computourist/RFM69-MQTT-client/DHT end node/DHT-node.png

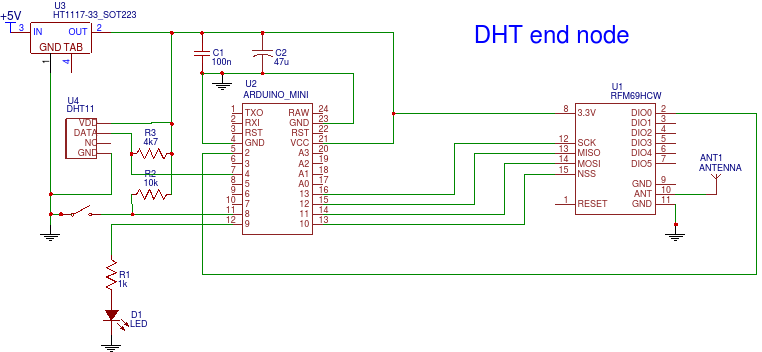
DHT end node/DHT-node.png
