computourist/RFM69-MQTT-client/DIG end node/DIG-node.png

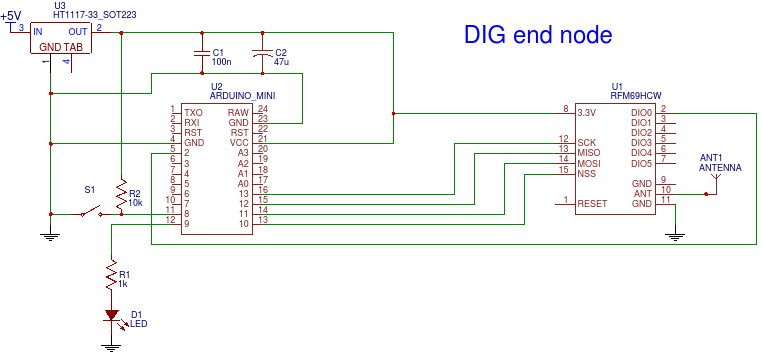
DIG end node/DIG-node.png
