computourist/RFM69-MQTT-client/DIG end node/DIG_node_relay.PNG

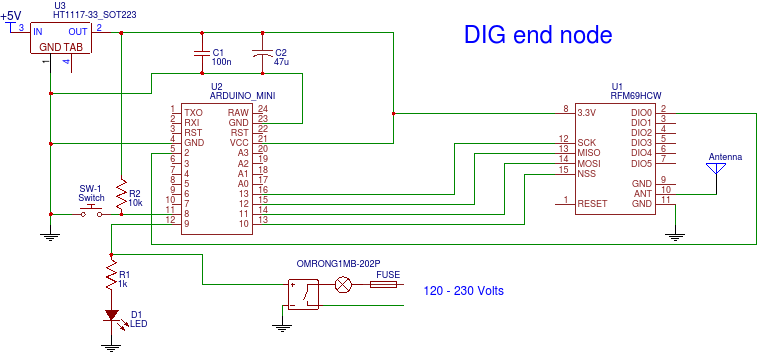
DIG end node/DIG_node_relay.PNG
