computourist/RFM69-MQTT-client/Gateway_2.5/MQTT-GTW.png

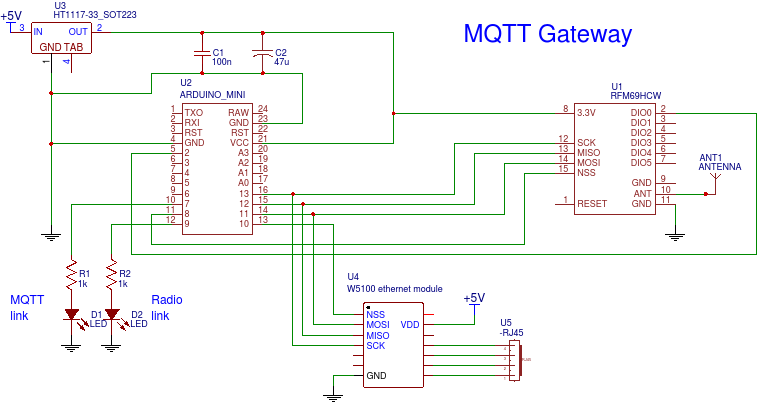
Gateway_2.5/MQTT-GTW.png
