computourist/RFM69-MQTT-client/(threads)

Thread 1 (2015-01-28):

Gateway stops functioning after a couple of polls/writes

cub69, 2015-01-28:
Hi, nice solution.  I've built both the gateway and the node.  The hardware I'm using is slightly different, I'm using arduino Mega 2560's, a different ethernet device - but the library (UIPethernet) is appartently 100% compatible with ethernet.h.
The gateway comes up and on my mosquito side I see it begin to send PINGREQ and getting PINGRESP.
I bring up the node and it sends a dev99 and then the temp/humidity.  I will see this publish if the gateway has not already gotten lost.  After a few minutes the gateway just stops - no more ping requests, and no more forwarding of data.  If I do a soft reset it comes back to life until it stops again.  Any suggestions on how to figure this out?  It most often stops after receiving sensor data, but has occasionally stopped without receiving it as well.

Thx

computourist, 2015-01-28:
Hi Cub69,

This is probably a hardware problem. I myself never encountered such problems; my gateway/node hase been running weeks at a time without problems.
Others have had such ussues, and found solutions. Maybe the discussions on http://homeautomation.proboards.com/ are of use to you...
- Computourist

cub69, 2015-01-28:
thanks found the forum - looking at solutions.

Closed 2015-01-28.

Thread 2 (2015-02-21):

using serial instead of Ethernet

einsiedlerkrebs, 2015-02-21:
Hello Computourist,

i am happy to find your code, since i was looking for an MQTT(-SN) implementation for arduinos and RFM69. I was wondering how it would be possible, to run the gateway without an Ethernet shield, but an UART-serial instead? The scenario would be, that the GW-Arduino is connected to a third device (i.e. openWRT-machine with broker) using the serial to communicate with the broker.
An advatage is that you could use  a arduino pro mini with 3.3V directly with the radio modules an lower the hardware costs.

Thank you for the code (!) and for your help.

computourist, 2015-02-21:
Hello Einsiedlerkrebs,

I chose for this setup for the following reasons:
- MQTT is designed to run on top of TCP/IP ; running it over a serial line means a proprietary solution and needs extra code on the receiving end (Mosquitto).
- The gateway is an important part of the installation. I do not like the idea of building a bottleneck (limited serial transfer speed) in such a central part.
- The physical location of the gateway is determined by coverage of the radio network. Your radio gateway will probably not sit right next to your Mosquitto broker, as would be needed for a serial connection. Ethernet gives you the freedom of physically moving the gateway around.
- The extra cost is just one ethernet module. You only need a single gateway per installation, so this would not seem a great problem.

I know that development is going on to implement a gateway together with a broker on Raspberry Pi. Have a look to the following forum for some inspiration:

http://homeautomation.proboards.com/

Regards,
- Computourist

einsiedlerkrebs, 2015-02-23:
hi,

i do not mean, to make RFM69-MQTT-client depending on such a setting, but still it would be usefull. In my case i would like to use it in such a way, since

* i have 3.3v Arduinos (Ethernet shield will not work)
* i could port the serial to udp via socat.

is it not possible, to use such a setting via an ifdef option? I am just asking cause i dont know, ho to change the Ethernet based commands to serial based ones.

Regards

einsiedlerkrebs

computourist, 2015-02-23:
Hi,
- you can use the ethershield with a 3.3 Volt Arduino.
- you cannot change the Ethernet based commands to serial ones. MQTT is based on TCP/IP and you cannot send it over serial. You could build a workaround, but on de broker-machine you would need code to convert the serial back to MQTT. Socat is character based and will not work straight away.

Rgds,
Computourist

Closed 2015-03-03.

Thread 5 (2015-04-29):

version 2.2 Gateway -- Freezing

davidhrbaty, 2015-04-29:
Hello computourist,
I'm trying your code of Gateway, but I have big strange with freezing after several minutes. When I turned off debug, it was better to take uptime several minutes. Can you advise me, where can be a  problem? I downloaded the newest version RFM libraries, but problem still persist.

Thank you

computourist, 2015-05-12:
Hi David,

Sorry for the delay in replying; I have been abroad for some time.

It is hard for me to debug your gateway. You would have to indicate exactly
how you put together the hardware and how you implemented your MQTT broker.
Is your gateway faulty or are the end nodes failing ? Is the link with the
broker down or not ?

My experience is these problems in most cases are power supply related.
Make sure your power supply delivers enough current and yout 3.3 Volts
supply for the RFM module can deliver the current needed in high-power
mode. Decoupling of the power supply is needed.

Good luck !

Computourist

2015-04-29 23:33 GMT+02:00 David Hrbaty <notifications@github.com>:

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

davidhrbaty, 2015-05-12:
Hi computourist,

Thank you for your response. I know, that it is hard to debug my gateway. So I include my schematic, because I have used arduino with 5V, so I must use 74HC4050 between arduino board and rfm69hw board. There is schematic:

https://lh4.googleusercontent.com/-vKxMicnYmfQ/VVJO1UJzJ6I/AAAAAAAAEOE/YZsUyeWj1cg/w958-h552-no/rfm69_schematic.png

After main change in your code, especially with mqttclient loop:
```
long watchdogInterval = 2000;

if (millis() > watchdog) {
    watchdog += watchdogInterval;
    if (!mqttClient.connected() && !connect_mqtt()) {
      return;
    }
    noInterrupts();
    mqttClient.loop();
    interrupts();
}
}	// end loop

boolean connect_mqtt() {
   mqttCon = 0;
   digitalWrite(MQCON, LOW);
  if (mqttClient.connect(clientName)) {
      mqttCon = 1;				// Yes, we have a link so,
      digitalWrite(MQCON, mqttCon);	// turn on MQTT link indicator and
      mqttClient.subscribe(subTopic);	// re-subscribe to mqtt topic
    return true;
  }
  return false;
}
```
I got uptime for several days. After four days of operation I got freeze of gateway. My wireless nodes are up, but have no connection. After restart gateway, wireless nodes have connection again.

When gateway is in freeze mode, it does not respond to any mqtt message.
MQTT broker (mymousquito) is on the same subnet that wireless gateway.

Thank you for your time.

computourist, 2015-05-13:
Hello David,

have you changed the interrupt handling in file W5100.h before compiling, as indicated in the header of the sketch ?

Rgds,

davidhrbaty, 2015-05-13:
Hi computourist,

Do you mean changes in w5100.h ? Especially this section:
```
#else
inline static void initSS() { DDRB |= _BV(2); };
inline static void setSS() { cli(); PORTB &= ~_BV(2); };
inline static void resetSS() { PORTB |= _BV(2); sei(); };
#endif
```

Because I forgot to change it. I think, that there will be whole problem. I'll try it when I 'll be at home during weekend.

I'll write here the result. Thank you again for your advice.

computourist, 2015-05-13:
Without these changes in W5100.h the RFM69 tries to seize the SPI bus at the same time as ethernet.

Gizzbert, 2015-05-30:
ah, thanks, this helped, I also overlooked it, might be helpful to add the following to the sketch of the gateway:
    //                change %program files\arduino\libraries\Ethernet\src\utility\w5100.h:
    //                #else
    //                inline static void initSS() { DDRB |= _BV(2); };
    //                inline static void setSS() { cli(); PORTB &= ~_BV(2); };
    //                inline static void resetSS() { PORTB |= _BV(2); sei(); };
    //                #endif

thanks, gateway works like a charm now :)

computourist, 2015-05-31:
Good to hear you got it all working now. Have fun !

Closed 2015-05-31.

Thread 6 (2015-05-20):

Unable to use both Ethernet Shield and RFM69 - SPI Slave Problem?

TP1337, 2015-05-20:
Hi, I have a problem regarding the radio and ethernet module.
First of all I tried your setup with a Pro Mini (as in the images) and also with an Uno R3 and level converter so that the RFM69 won't get damaged. Both Arduinos are "compatbile" China versions. I tried two China ethernet shields and I also got the genuine ethernet shield.

Which Arduino IDE are you using? Currently I'm using 1.65 and also tried 1.60. I changed two lines in the w5100.h but it won't work. If I unplug the RFM69 power it instantly connects to the MQTT broker, so it's probably due to the SPI problem.

Please tell me which IDE version you are using and if I should try some different ethernet or SPI files. Thank you very much!

computourist, 2015-05-21:
Hi TP,

I'm using an old version of Arduino IDE (1.05), never bothered to upgrade. But that should not cause any problems.

The SPI conflict only occurs when the RFM module receives a radio packet. The RFM will generate an interrupt request and will access the SPI bus. By disabling responses to the interrupt request whilst the ethernet module is using the SPI bus this problem is solved.

This means the connection to the MQTT broker should be established and remain connected until a conflict occurs. If you have no end node transmitting, no packets are received and the connection with the MQTT-broker should not be affected.

I think you have a different problem.
What is the serial output with/without the RFM connected ? Have you checked your supply voltages with/without the RFM ?

Leaving out the LED's is no problem.

TP1337, 2015-05-21:
Hi computourist,
thank you very much for your quick response! Your comment helps me a lot.

I tried both mb102 as well as usb (and batteries). Maybe it's a good idea to connect it to a better voltage source to be sure it's not a power problem. I will also try IDE 1.05 - all I have to is to set ip, mac etc. and change the two lines in the w5100.h header file, right? Just asking because it doesn't seem to work although I'm trying very hard and I'm experienced with this kind of setups.

If I connect both the rfm69 (not high power version) and ethernet to the pro mini or uno the console only says "failed to connect" once and then kind of freezes. Without the rfm69 it connects immediatedly after one failed connect. I will check everything asap.

Thank you very much for your help!

TP1337, 2015-05-22:
Hi computourist,
I tried several voltage sources but it just wont work. IDE 1.05 didnt help either.

If I use the pro mini I can't even connect to the server - using the same on the UNO sketch I can connect to the mqtt server but only without MISO connected between RFM69 and Arduino UNO. I tried several ethernet shields as well as many boards. Do you think the problem might be related to the boards not beeing genuine ones? The uber homeautomation sketches (Eric Tsai) are working without any problems so far... I really dont know what to do. Do you have any advice for me or could you give me any hints?

I should have the correct wiring between pro mini/ UNO (with level shifter) and I also have set the everything correctly up (mac, mqtt server ip, ...). What else could I try? Its impossible everybody else gets this sketch to work except for me. I also changed the w5100.h according to your description. I even tried HCW and CW versions of the module.

In order to use your setup: can I leave the sketch RFM_MQTT_GW_22.ino as it is except for some values like HCW, mac, ip, password etc.?

Thank you so much!

computourist, 2015-05-25:
Difficult to diagnose your problems. The fact that you get a connection with MISO disconnected suggest a problem with the sharing of the SPI bus. The uber sketches of Eric avoid sharing the bus by using 2 Arduino's connected with a serial link.
Do you use level-shifters ? If so, how are they connected ? Are they 3-state (on,off, float) so you can float the SPI-bus for other devices to use ?
- The gateway sketch can be used as-is; only thing you need to change are some parameters.
- The MQTT-connection always shouts: "no connection" before connecting.. (bad programming)
- The boards I use are China-clones; no problem with that...

Success....

Closed 2015-06-16.

Thread 7 (2016-01-12):

Question not an issue

djash40, 2016-01-12:
Hi, I am new to programming and please excuse my ignorance in asking these questions. I have  2  moteinos and I have a working sketch that I would like to connect to MQTT. One as a node and one as the gateway connected to a Raspberry Pi for network communications. So far I have the end node communicating with the gateway and printing out to the serial port on the gateway . Now I would like to take the serial port and communicate over MQTT.  This is where I'm stuck on making a choice. I have looked at many options Ruby Python and of course your code to create the serial to mqtt connection and I'm not sure where to go next. While looking at your code it seems it requires an Ethernet shield on the moteino.  Is this correct?  Or can I use my Raspberry Pi's  Mac address in the gateway sketch?  Please advise.

computourist, 2016-01-13:
Which sketch have you implemented ? The gateway described here connects to fixed ethernet only. A serial output is provided, but only for informational debugging messages.
A Raspberry Pi is not needed for this gateway (although it could be used to run Mosquitto)

Closed 2016-08-04.

Thread 8 (2016-01-23):

Arduino IDE 1.6.7 compiler failure

skywayne, 2016-01-23:
Trying to compile the Gateway with Arduino IDDE 1.6.7 gives the error 'mqtt_subs' not declared in this scope for the line -PubSubClient mqttClient(mqtt_server, 1883, mqtt_subs, ethClient );

Moving the function above this line then gives an error as mqttclient is not declared and is used in mqtt_subs.  I seem to be chasing my tail here?  Any ideas?

militis01, 2016-01-23:
I ran into the same problem. I solved it by defining a prototype of the Mqtt_subs function above the mqtt_client instantiation.

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

skywayne, 2016-01-23:
Thanks - I will try that and see if Gateway fully operational.

computourist, 2016-01-23:
Seems the arduino IDE is handling things a bit different now.
Have a look at:
http://homeautomation.proboards.com/thread/94/solved-mqtt-subs-declared-scope

Computourist

computourist, 2016-01-31:
Released version 2.4 where this problem is solved.

Closed 2016-01-31.

Thread 9 (2016-02-05):

nRF24l01+ support

petrolej, 2016-02-05:
Hi,

great job. I am about to set your code in my home. This is exactly what I was looking for. I needed an arduino based gateway which would be only a bridge between a wireless node and ethernet and acts as a subscriber for a distant MQTT broker.

I wonder whether the code could be altered to work with nRF24l01+ which is much cheaper.

Keep doing well.

Petr

computourist, 2016-02-05:
Hi,
Thanx for the kind words..

With respect to using nRF24l01: It works in the 2.4 GHz band, so its range and abiliy to penetrate walls is less that the RFM-Module that works in a lower frequency band. On Top: the RFM-69 module gives you encryption, making communications safe.
For me these are arguments not to use nRF24l01...

Regards,
Computourist

Closed 2016-03-04.

Thread 10 (2016-03-03):

Gateway up or down

bcomsugi, 2016-03-03:
Hi, how do you know if the gateway is up or down?
i can't ping the gateway, and the gateway seem didnt implement reconnect if the connection(LAN) is disconnected

militis01, 2016-03-04:
I am using an Mqtt client (lens) in chrome browser to send status request messages to the gateway. The documentation on the gateway covers how to do that.

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

computourist, 2016-03-04:
You should be able to ping the LAN-connection of your gateway. If this is not the case, do you have a link-indicator on your ethernet port ? Is you MAC-adrress (as defined in the sketch) unique in your network?
If the ethernet port is up, the MQTT LED will indicate connection to you broker. In debug mode, a connection message will be present on the serial port.

Closed 2016-08-04.

Thread 11 (2016-03-29):

Gateway 2.4 is not working, no debugging output

DuckY1987, 2016-03-29:
Hello,

i'm rather fresh in this topic, but the gateway 2.4 is not working.

I tried to use an arduino uno with ethernet shield, i adjusted all values and uncommented the debug parameter for radio, but i don't see any debug information, neither the normal startup 433MHZ listening.

I tried the Gateway 2.3 and figured out this had problems with the mqtt_sub, i removed it and got at least the debug information in the CLI.

No i wonder what could it be, my radio chip is perfectly soldered and i don't have shortcuts.

My test sensor node is an arduino pro mini with rfm69hw connected, it sends data but i don't see any at the gateway with the old code. How can i display received data on the CLI in the debug section to my understanding no self-test is included.

Probably the void setup in the new code causes troubles because i don't see output at all in the CLI and its a part of the initialization, i had to remove it in the Version 2.3 as well to get at least some code compiled and loaded.

Do you have a sample code to check my rfm69hw chips or some hint that you heard abt similar problems?

Wiring was with Version 2.4 to PIN 8 and in the 2.3 Version to PIN 10.

My gateway and the node are both connected via USB and serial interface to my notebook.

I used normal phone cable to solder it, i checked as well with a volt meter the transition to the arduino pins, everthing is fine, i'm a bit clueless now what could it be else, i'm abt to solder cables another rfm69 chip to figure out if it causes troubles.

Some ideas or known issues?

Do you have a simple sample send/receive code, to verify if the chips work as expected?

Thats my code:

// RFM69 MQTT gateway sketch
//
// This gateway relays messages between a MQTT-broker and several wireless nodes and will:
// - receive sensor data from several nodes periodically and on-demand
// - send/receive commands from the broker to control actuators and node parameters
//
//	Connection to the MQTT broker is over a fixed ethernet connection:
//
//		The MQTT topic is /home/rfm_gw/direction/nodeid/devid
//		where direction is: southbound (sb) towards the remote node and northbound (nb) towards MQTT broker
//
//	Connection to the nodes is over a closed radio network:
//
//		RFM Message format is: nodeID/deviceID/command/integer/float/string
//		where Command = 1 for a read request and 0 for a write request
//
//	Current defined gateway devices are:
//	0	uptime:			gateway uptime in minutes
//	3	Version:		read version gateway software
//
//	Reserved ranges for node devices, as implemented in the gateway are:
//	0  - 16				Node system devices
//	16 - 32				Binary output (LED, relay)
//	32 - 40				Integer output (pwm, dimmer)
//	40 - 48				Binary input (button, switch, PIR-sensor)
//	48 - 64				Real input (temperature, humidity)
//	64 - 72				Integer input (light intensity)
//
//	72	string:			transparant string transport
//
//	73 - 90		Special devices not implemented in gateway (yet)
//
//	Currently defined error messages are:
//	90	error:			Tx only: error message if no wireless connection
//	91	error:			Tx only: syntax error
//	92	error:			Tx only: invalid device type
//	99	wakeup:			Tx only: sends a message on node startup
//
//	==> Note:
//		- Interrupts are disabled during ethernet transactions in w5100.h (ethernet library)
//		  (See http://harizanov.com/2012/04/rfm12b-and-arduino-ethernet-with-wiznet5100-chip/)
//		- Ethernet card and RFM68 board default use the same Slave Select pin (10) on the SPI bus;
//		  To avoid conflict the RFM module is controlled by another SS pin (8).
//
//
// RFM69 Library by Felix Rusu - felix@lowpowerlab.com
// Get the RFM69 library at: https://github.com/LowPowerLab
// Get the MQQT client library at: https://github.com/knolleary/pubsubclient
//
// version 1.8 - by Computourist@gmail.com december 2014
// version 1.9 - fixed resubscription after network outage  Jan 2015
// version 2.0 - increased payload size; standard device types; trim float values; uptime & version function gateway;	Jan 2015
// version 2.1 - implemented string device 72; devices 40-48 handled uniformly		Feb 2015
// version 2.2 - changed handling of binary inputs to accomodate Openhab: message for ON and OFF on statechange;
//			   - RSSI value changed to reception strength in the gateway giving a more accurate and uptodate value ; March 2015
// version 2.3 - System device 9 (number of retransmissions) implemented in gateway	;
//			   - Deleted debug option 's' to toggle push interval due to memory constraints;  Oct 2015
// version 2.4 - fixed function declaration to comply with new Arduino IDE;
//			   - changed debug routines to comply with memory constraints; 		Jan 2016

#include <RFM69.h>
#include <SPI.h>
#include <Ethernet.h>
#include <PubSubClient.h>
// void mqtt_subs(char* topic, byte* payload, unsigned int length);

#define DEBUGRADIO					// uncomment for radio debugging
//#define DEBUG       // uncomment for MQTT debugging
#define VERSION "GW V2.4"

// Ethernet settings
byte mac[] = { 0xDE, 0xAD, 0xBE, 0xEF, 0xBA, 0xBE };	// MAC address for ethernet
byte mqtt_server[] = { 172, 17, 0, 6};		// MQTT broker address (Mosquitto)
byte ip[] = { 172, 17, 0, 9 };			// Gateway address (if DHCP fails)

// Wireless settings
#define NODEID 1				// unique node ID in the closed radio network; gateway is 1
#define RFM_SS 8				// Slave Select RFM69 is connected to pin 8
#define NETWORKID 100				// closed radio network ID

//Match frequency to the hardware version of the radio (uncomment one):
#define FREQUENCY RF69_433MHZ
//#define FREQUENCY RF69_868MHZ
//#define FREQUENCY RF69_915MHZ

#define ENCRYPTKEY "QWERGBNMKJHGFDSA" 		// shared 16-char encryption key is equal on Gateway and nodes
#define IS_RFM69HW 				// uncomment only for RFM69HW! Leave out if you have RFM69W!
#define ACK_TIME 50 				// max # of ms to wait for an ack

// PIN settings
#define MQCON 7					// MQTT Connection indicator
#define R_LED 9					// Radio activity indicator
#define SERIAL_BAUD 115200

typedef struct {				// Radio packet structure max 66 bytes
int		nodeID;				// node identifier
int		devID;				// device identifier 0 is node; 31 is temperature, 32 is humidity
int		cmd;				// read or write
long		intVal;				// integer payload
float		fltVal;				// floating payload
char		payLoad[32];			// char array payload
} Message;

Message mes;

int	dest;				// destination node for radio packet
int     DID;                    		// Device ID
int 	error;					// Syntax error code
long	lastMinute = -1;			// timestamp last minute
long	upTime = 0;				// uptime in minutes
bool	Rstat = false;				// radio indicator flag
bool	mqttCon = false;			// MQTT broker connection flag
bool	respNeeded = false;			// MQTT message flag in case of radio connection failure
bool	mqttToSend = false;			// message request issued by MQTT request
bool	promiscuousMode = false;		// only receive closed network nodes
bool	verbose = true;				// generate error messages
bool	IntMess, RealMess, StatMess, StrMess;	// types of messages
long	onMillis;				// timestamp when radio LED was turned on
char	*subTopic = "home/rfm_gw/sb/#";		// MQTT subscription topic ; direction is southbound
char	*clientName = "RFM_gateway";		// MQTT system name of gateway
char	buff_topic[30];				// MQTT publish topic string
char	buff_mess[32];				// MQTT publish message string

RFM69 radio;
EthernetClient ethClient;
PubSubClient mqttClient(mqtt_server, 1883, ethClient );

//
//==============	SETUP
//

void setup() {
#ifdef DEBUG
	Serial.begin(SERIAL_BAUD);
#endif
#ifdef DEBUGRADIO
  Serial.begin(SERIAL_BAUD);
#endif
radio.setCS(RFM_SS);					// change default Slave Select pin for RFM
radio.initialize(FREQUENCY,NODEID,NETWORKID);		// initialise radio module
#ifdef IS_RFM69HW
radio.setHighPower(); 					// only for RFM69HW!
#endif
radio.encrypt(ENCRYPTKEY);				// encrypt with shared key
radio.promiscuous(promiscuousMode);			// listen only to nodes in closed network

pinMode(R_LED, OUTPUT);					// set pin of radio indicator
pinMode(MQCON, OUTPUT);					// set pin for MQTT connection indicator
digitalWrite(MQCON, LOW);  				// switch off MQTT connection indicator
digitalWrite(R_LED, LOW);				// switch off radio indicator

#ifdef DEBUG
	Serial.print("GW Version ");
	Serial.println(VERSION);
	Serial.print("\n ");
	Serial.print(FREQUENCY==RF69_433MHZ ? 433 : FREQUENCY==RF69_868MHZ ? 868 : 915);
	Serial.println(" Mhz...");
#endif

	if (Ethernet.begin(mac) == 0) {			// start the Ethernet connection
#ifdef DEBUG
	Serial.println("No DHCP");
#endif
	Ethernet.begin(mac, ip);
}

#ifdef DEBUG
	Serial.println("connecting");
#endif

	delay(1000);
	mqttCon = 0;					// reset connection flag
	while(mqttCon != 1){				// retry MQTT connection every 2 seconds
#ifdef DEBUG
	Serial.println("no link");
#endif
	mqttCon = mqttClient.connect(clientName);	// retry connection to broker
	delay(2000);					// every 2 seconds
	}

	if(mqttCon){					// Connected !
#ifdef DEBUG
	Serial.println("MQTT-link OK");
#endif
	digitalWrite(MQCON, HIGH);			// switch on MQTT connection indicator
	mqttClient.subscribe(subTopic);			// subscribe to all southbound messages
	}
#ifdef DEBUG
	else Serial.println("MQTT-link NOK");
#endif
}	// end setup

//
//==============	MAIN
//

void loop() {

// CONTROL RADIO LED AND CALCULATE UPTIME
//

if (Rstat) {						// turn off radio LED after 100 msec
		if (millis() - onMillis > 100) {
		Rstat = false;
		digitalWrite(R_LED, LOW);
		}
}

if (lastMinute != (millis()/60000)) {			// another minute passed ?
	lastMinute = millis()/60000;
	upTime++;
	}

// RECEIVE AND SEND MESSAGES
//

if (mqttToSend) {sendMsg(dest);}		// send MQTT instruction packets over the radio network

if (radio.receiveDone()) { processPacket();}	// check for received radio packets and construct MQTT message

if (!mqttClient.loop()) {			// check connection MQTT server and process MQTT subscription input
	mqttCon = 0;
	digitalWrite(MQCON, LOW);
	while(mqttCon != 1){			// try to reconnect every 2 seconds
		mqttCon = mqttClient.connect(clientName);
		delay(2000);
	}
	if(mqttCon){				// Yes, we have a link so,
		digitalWrite(MQCON, mqttCon);	// turn on MQTT link indicator and
		mqttClient.subscribe(subTopic);	// re-subscribe to mqtt topic
	}
}
}	// end loop

//
//==============	SENDMSG
//
//	sends messages over the radio network

void sendMsg(int target) {

Rstat = true;						// radio indicator on
digitalWrite(R_LED, HIGH);				// turn on radio LED
onMillis = millis();					// store timestamp

int i = 5;						// number of transmission retries

while (respNeeded && i>0) {				// first try to send packets

if (radio.sendWithRetry(target, (const void*)(&mes), sizeof(mes),5)) {
	respNeeded = false;
#ifdef DEBUGRADIO
	Serial.print("Msg to node " );
	Serial.println(target);
#endif
	} else delay(500);				// half a second delay between retries
	i--;
}

if (respNeeded && verbose) { 					// if not succeeded in sending packets after 5 retries
	sprintf(buff_topic, "home/rfm_gw/nb/node%02d/dev90", target);	// construct MQTT topic and message
	sprintf(buff_mess, "radio lost node %d", target);		// for radio loss (device 90)
	mqttClient.publish(buff_topic,buff_mess);			// publish ...
	respNeeded = false;						// reset response needed flag
#ifdef DEBUGRADIO
	Serial.print("No node ");
	Serial.println(target);
#endif
}

if (mqttToSend) mqttToSend = false;				// reset send trigger

}	// end sendMsg

//
//==============	PROCESSPACKET
//
// receives data from the wireless network, parses the contents and constructs MQTT topic and value

void processPacket() {
Rstat = true;							// set radio indicator flag
digitalWrite(R_LED, HIGH);					// turn on radio LED
onMillis = millis();						// store timestamp

if (radio.DATALEN != sizeof(mes))				// wrong message size means trouble
#ifdef DEBUGRADIO
	Serial.println("inv msg strct")
#endif
;
else								// message size OK...
{
	mes = *(Message*)radio.DATA;				// copy radio packet
								// and construct MQTT northbound topic

	sprintf(buff_topic, "home/rfm_gw/nb/node%02d/dev%02d", radio.SENDERID, mes.devID);

#ifdef DEBUGRADIO
	Serial.print(radio.SENDERID);	Serial.print(",");
	Serial.print(mes.devID);	Serial.print(",");
	Serial.print(mes.intVal);	Serial.print(",");
	Serial.print(mes.fltVal);	Serial.print("Node ");
	Serial.println();
#endif
}
DID = mes.devID;						// construct MQTT message, according to device ID

IntMess = (DID==0 || DID==1 || DID==7 || DID==9 || (DID>=64 && DID<72));	// Integer in payload message
RealMess = (DID==4 || (DID>=48 && DID <64));					// Float in payload message
StatMess = (DID==5 || DID==6 || DID==8 || (DID>=16 && DID <32) || (DID>=40 && DID <48));		// Status in payload message
StrMess = (DID==3 || DID==72);			// String in payload

if (IntMess) {							// send integer value	load
	sprintf(buff_mess, "%d",mes.intVal);
	}

if (RealMess) {							// send decimal value
	dtostrf(mes.fltVal, 10,2, buff_mess);
	while (buff_mess[0] == 32) {				// remove any leading spaces
		for (int i =0; i<strlen(buff_mess); i++) {
		buff_mess[i] = buff_mess[i+1];
		}
	}
	}

if (StatMess) {							// put status in payload
	if (mes.intVal == 1 )sprintf(buff_mess, "ON");
	if (mes.intVal == 0 )sprintf(buff_mess, "OFF");
	}

if (StrMess) {
int i; for (i=0; i<32; i++){
	buff_mess[i] = (mes.payLoad[i]);
}
}

switch (mes.devID)
{
case (2):							// RSSI value
{	sprintf(buff_mess, "%d", radio.RSSI);
}
break;
case (92):							// invalid device message
{	sprintf(buff_mess, "NODE %d invalid device %d", mes.nodeID, mes.intVal);
}
break;
case (99):							// wakeup message
{	sprintf(buff_mess, "NODE %d WAKEUP", mes.nodeID);
}
break;
}	// end switch

#ifdef DEBUG
Serial.print("MQTT msg: ");
Serial.print(buff_topic);
Serial.print(": ");
Serial.println(buff_mess);
#endif

mqttClient.publish(buff_topic,buff_mess);			// publish MQTT message in northbound topic

if (radio.ACKRequested()) radio.sendACK();			// reply to any radio ACK requests

}	// end processPacket

//
//==============	MQTT_SUBS
//
//		receive messages from subscribed topics
//		parse MQTT topic / message and construct radio message
//
//		The values in the MQTT topic/message are converted to corresponding values on the Radio network
//

void mqtt_subs(char* topic, byte* payload, unsigned int length) {

	int i;
	mes.nodeID = NODEID;				// gateway is node 1
	mes.fltVal = 0;
	mes.intVal = 0;
	mqttToSend = false;				// not a valid request yet...
	error = 4;						// assume invalid device until proven otherwise

#ifdef DEBUG
	Serial.print("MQTT-Topic: ");
	Serial.println(topic);
#endif

if (strlen(topic) == 27) {				// correct topic length ?
	dest = (topic[19]-'0')*10 + topic[20]-'0';	// extract target node ID from MQTT topic
	DID = (topic[25]-'0')*10 + topic[26]-'0';	// extract device ID from MQTT topic
	payload[length] = '\0';				// terminate string with '0'
	String strPayload = String((char*)payload);	// convert to string
	mes.devID = DID;
	mes.cmd = 0;					// default is 'SET' value
	if (strPayload == "READ") mes.cmd = 1;		// in this case 'READ' value
	if (length == 0) {error = 2;}                   // no payload sent
	else {
	StatMess = ( DID==5 || DID==6 || DID==8 || (DID>=16 && DID<32));
	RealMess = (( DID==0 || DID==2 || DID==3 || DID==4 || (DID>=40 && DID<72))&& mes.cmd==1);
	IntMess = (DID==1 || DID==7 || DID==9 || (DID >=32 && DID <40));
	StrMess = (DID==72);

	if (dest == 1 && DID == 0) {					// gateway uptime wanted
		sprintf(buff_mess,  "%d", upTime);
		sprintf(buff_topic, "home/rfm_gw/nb/node01/dev00");	// construct MQTT topic and message
		mqttClient.publish(buff_topic,buff_mess);		// publish ...
		error =0;
		}
	if (dest == 1 && DID == 3) {					// gateway version wanted
		for (i=0; i<sizeof(VERSION); i++){
		buff_mess[i] = (VERSION[i]); }
		mes.payLoad[i] = '\0';
		sprintf(buff_topic, "home/rfm_gw/nb/node01/dev03");	// construct MQTT topic and message
		mqttClient.publish(buff_topic,buff_mess);		// publish ...
		error =0;
		}
	if (dest>1 && StatMess) {					// node status device
		mqttToSend = true;
		if (strPayload == "ON") mes.intVal = 1;			// payload value is state
		else  if (strPayload == "OFF") mes.intVal = 0;
		else if (strPayload != "READ") { mqttToSend = false; error = 3;}// invalid payload; do not process
		}
	if (dest>1 && (DID >=40 && DID <48)) {
		if (strPayload == "READ") mqttToSend = true;
		else {mqttToSend = false; error = 3;}		// invalid payload; do not process
		}
	if (dest>1 && RealMess) {					// node read device
		mqttToSend = true;
		}

	if ( dest>1 && IntMess ) {					// node integer device
		if (mes.cmd == 0) mes.intVal = strPayload.toInt();	// timer/polling/Integer is in MQTT message
		mqttToSend = true;
		}
	if ( dest>1 && StrMess ) {					// node string device
		if (mes.cmd == 0) {
		int i; for (i=0; i<32; i++){
		(mes.payLoad[i])=payload[i];
		}}
		mqttToSend = true;
		}

	if (mqttToSend && (error == 4)) error = 0;		// valid device has been selected, hence error = 0
	respNeeded = mqttToSend;			// valid request needs radio response
#ifdef DEBUGRADIO
	Serial.println(strPayload);
	Serial.print("Val:");
	Serial.println(mes.intVal);
#endif
	}

}

else {
	error = 1;
#ifdef DEBUG
	Serial.println("MQTT-subscr NOK");
#endif
	}
if ((error != 0) && verbose) { 					// in case of syntax error
	sprintf(buff_mess, "syntax error %d for node %d", error,dest);
	sprintf(buff_topic, "home/rfm_gw/nb/node01/dev91");	// construct MQTT topic and message
	mqttClient.publish(buff_topic,buff_mess);		// publish ...
#ifdef DEBUG
Serial.print("Syntax err: ");
Serial.println(error);
#endif
	}
} // end mqttSubs

Best regards,
Thomas

computourist, 2016-04-02:
Hi Thomas,

always difficult to troobleshoot at a distance..

Some thoughts:
- your sketch should display debug info if you compiled with the debug option. Check your COM settings (baud rate, COM port, etc)
- If you connected your RFM69 to an Arduino it is probably gone. The RFM69 does not withstand 5 Volts; it is meant to operate on 3.3 Volts on VSS and inputs.
- try to split up your faultfinding: first troubleshoot the MQTT connection. Use another client to send commands to you gateway and see if it responds. Once you have that working start troubleshooting the radio part.
- Have a look at our forum: http://homeautomation.proboards.com Lots of solutions and problems have been discussed there and there are always people willing to lend a helping hand....

Success,
Computourist

Closed 2016-08-04.

Thread 12 (2017-02-07):

Arduino compiler error

dome2048, 2017-02-07:
I'm using:

Mac OS X 10.12.3
Arduino IDE 1.8.1
Arduino Uno (using logic level converters and with radio connected to 3.3v)

I installed the RFM69 library manually and the SPI library through the library manager. When I go to compile RFM_MQTT_GW_25, I get the following error log:

`
/Users/dome/Documents/Arduino/libraries/RFM69-master/RFM69_OTA.cpp: In function 'void HandleHandshakeACK(RFM69, SPIFlash, uint8_t)':
/Users/dome/Documents/Arduino/libraries/RFM69-master/RFM69_OTA.cpp:80:16: error: 'class SPIFlash' has no member named 'initialize'
     if (!flash.initialize())
                ^
/Users/dome/Documents/Arduino/libraries/RFM69-master/RFM69_OTA.cpp: In function 'uint8_t HandleWirelessHEXData(RFM69, uint8_t, SPIFlash, uint8_t, uint8_t)':
/Users/dome/Documents/Arduino/libraries/RFM69-master/RFM69_OTA.cpp:124:9: error: 'class SPIFlash' has no member named 'blockErase32K'
   flash.blockErase32K(0);
         ^
/Users/dome/Documents/Arduino/libraries/RFM69-master/RFM69_OTA.cpp:125:9: error: 'class SPIFlash' has no member named 'writeBytes'
   flash.writeBytes(0,"FLXIMG:", 7);
         ^
/Users/dome/Documents/Arduino/libraries/RFM69-master/RFM69_OTA.cpp:174:50: error: 'class SPIFlash' has no member named 'blockErase32K'
                 if (bytesFlashed%32768==0) flash.blockErase32K(bytesFlashed);//erase subsequent 32K blocks (possible in case of atmega1284p)
                                                  ^
exit status 1
Error compiling for board Arduino/Genuino Uno.`

I know there's been a lot of changes with the Arduino IDE lately; any idea why this broke or if it's simply user error?

computourist, 2017-02-08:
Did you load the correct libraries ? Somehow you are pointing to Flash memory on the SPI bus ??
I have never seen such references..

dome2048, 2017-02-09:
Okay, so I did get it to compile. I started with a fresh install of the Arduino IDE on a Raspberry Pi, and manually installed the RFM69.h, SPI.h, PubSubClient.h, and SPIFlash.h libraries from their respective Github sources.

I had to edit the library names and file locations for the IDE to see them, and had to add `#include <SPIFlash.h>` in order for the code to compile.

I do have quite a few libraries installed on my Mac Arduino IDE so it's possible there's some type of conflict.

Based on your advice from the other open issue, I'm waiting for my 3.3v Pro Micro and 3.3v w5100 module before I proceed to hardware testing, rather than fiddle with logic level converters.

If you think it would be helpful (perhaps I'm not the only one with this issue?), I'd be happy to do a PR for the readme file to explain how I got it to compile.

waynestronach, 2017-02-09:
I have built about 20 or so Nodes and gateways using RFM69HW, RFM69HC, and nanos, unos, megas of both original and clones (e.g sparfun) types.

I initially brought level converters, but haven't installed a single one and have had no problems over the last 24 months.  A 5V Arduino needs a voltage > 3V to register a 1(true).  3.3V with open collector (as per the RFM69s) works OK.

One issue to be aware of with the gateway is the need to edit the Arduino Ethernet library to ensure that the interrupts work correctly - see notes on the gateway or http://harizanov.com/2012/04/rfm12b-and-arduino-ethernet-with-wiznet5100-chip/

consolacion, 2017-02-13:
Getting the same 'class SPIFlash' has no member named .........' errors as dome2048.  Used the SPIFlash library from the library manager. Should i use another??

@dome2048 yes how did you solve it??

dome2048, 2017-02-16:
@consolacion I got it to compile on my mac by removing all my libraries and using a temporary sketch folder with only the 5 libraries, and with versions downloaded from GitHub, not the library manager. Sounds like we both found our way to the same solution though.

It does bear mentioning that I still needed to add `#include <SPIFlash.h>` to get the sketch to compile. I'll submit a PR for this.

consolacion, 2017-02-16:
Thanks, and indeed, I had found proper library already :-) However, I did not have to include the SPIFlash to the sketch.
So many libraries with same name :-)  beware that 'updating' through the library manager sometimes updates the wrong library

dome2048, 2017-02-16:
@consolacion Ah, I see - I reread your post and it makes more sense.

I'll close this issue. Thanks for the help everyone.

Closed 2017-02-16.

Thread 13 (2017-02-08):

Add schematic for Uno (5v) with level shifters + RFM

bpridemore, 2017-02-08:
Arduino 's running 5v e.g. Uno are popular, please add a drawing to the code base for wire hook ups thais including level shifters with RFM

Gizzbert, 2017-02-08:
RFM69HW does not work with the regular 5v uno due to higher input current
requirements,  it needs 150mA.

Op 8 feb. 2017 7:43 a.m. schreef "bpridemore" <notifications@github.com>:

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

computourist, 2017-02-08:
RFM69 is also likely to be damaged when IO ports are hooked up to 5 volts.
I have never used a setup with level shifters, so I cannot provide a schematic for a 'working' setup.
It might be easier to convert your UNO to 3.3 Volts.
Have a look at: https://learn.adafruit.com/arduino-tips-tricks-and-techniques/3-3v-conversion

bpridemore, 2017-02-08:
https://forum.arduino.cc/index.php?topic=373128.0
I'm pretty sure it's possible with level  shifters or converters.

computourist, 2017-02-08:
Yeah, I'm sure too.
In the gateway three devices (Uno, ethernet and RFM69) are connected to the same SPI signals. There is a need to 'float' the bus if no communication is taking place. This means extra restrictions on the way level shifters are used. Believe me, using a 3.3 Volt uno is a far better way to go.

computourist, 2017-02-08:
You might want to have a look at:
http://homeautomation.proboards.com/thread/114/logic-level-converters-rfm69hw
where a working config is dicussed.

consolacion, 2017-02-13:
for Node I use an 8MHz 3v3 Pro Mini, but as i want to use my arduino ethernetshield, I am kinda stuck on using a Uno and was going to use a levelshifter BOB or a CD4050. But as I like to keep my wiring simple, it might be a better idea to get a W5100 module and a 3v3 pro mini.
Having said that.. knowing the W5100 module will cost 5-8 euro, maybe an esp8266 Gateway might be a better idea..... hmmm got some thinking to do

computourist, 2017-04-12:
Hi Consolacion,

My feedback form the forum is that many find implementing the ESP8266 node a simpler way to start. The ESP8266 node incorporates an MQTT client and therefor needs no gateway. In this way a lot of  complexity is avoided.

consolacion, 2017-04-12:
Tnx yes indeed. Initially I came upon many people  experiencing problems with it, but I just now built another gateway with an Wemos D1 and that gave no problems.
By the way, I haven't been buying Elektor for a long time, but I may coz of yr article

Closed 2017-03-31.

Thread 14 (2017-03-30):

SIM800 GSM module

esawyja, 2017-03-30:
Would it be possible to send the sensor values to the Cloud directly via a SIM800 GSM module? IE for use where there is no internet available, if possible in MQTT format?

computourist, 2017-03-31:
Sure, it would be possible. But since MQTT needs a permanent connection, it would deplete your dataplan very soon.
A better way would be to collect and store your data locally and connect on a regular basis to upload your data using a dedicated api. In this way your connection cost over the GSM network can be limited.

esawyja, 2017-03-31:
Thanks, I did not know MQTT needs a permanent connection, I thought it will just be a short burst of info when you publish?

computourist, 2017-03-31:
If there is no permanent connection, the broker can never push a message. The client initiates the connection to the broker...

esawyja, 2017-03-31:
aaah ok, what I'm looking for is just the client part to work on a GSM
modem, so I would have the broker running in the Cloud and the Arduino and
SIM800 as a client, pushing sensor data to the broker

On Fri, Mar 31, 2017 at 11:47 AM, computourist <notifications@github.com>
wrote:

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

computourist, 2017-03-31:
I guess you could initiate an MQTT connection from your client, then tear down the connection after publishing your data. Not sure how Mosquitto would handle that and it seems overkill for just a data upload. Better to place the MQTT client in the cloud with a permanent connection to the broker and upload your data via API.

esawyja, 2017-03-31:
Ok, thanks, I will try that

On Fri, Mar 31, 2017 at 11:55 AM, computourist <notifications@github.com>
wrote:

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

Thread 15 (2017-04-12):

Elektor publishing your project / WIZ5100 bug /433Mhz node

consolacion, 2017-04-12:
Magazine Elektor in its dutch March/April 2017 is publishing your 'system'.
When they talk about 'the author', I presume it is you. (if not you better have a talk with then)
https://www.elektormagazine.nl/magazine/elektor-201703/40186.
Interesting though through the article I came across the "[WIZ5100 bug](http://john.crouchley.com/blog/archives/662)".  Fortunately I have not been plagued by that, but anybody  that has trouble getting things to work may want to have a look at John Crouchley's blog on the matter.

Elektor does mention an 433MHz Rf endnode. Any chance of you publishing that here too?

computourist, 2017-04-12:
Your assumption is right: Elektor asked me to describe the system in an article.
The WIZ5100 is a sneaky one. At first my gateway seemed to work OK, but every once in a while (days to weeks) it would hang for no obvious reason. After implementing the proposed solution my gateway works witghout problems for months at a row.
The 433 MHz Rf end node is described in: https://github.com/computourist/RFM69-MQTT-client/tree/master/Remote%20Control%20node.
I use it to control several KlikAanKlikUit wall switches I have lying around from earlier projects.

Regards,
Computourist

consolacion, 2017-04-12:
It is a very nice article. Congrats.
My experience with the WIZ5100 is similar, worked well, but when I just tried another module it didnt. The difference was a 74LVC14 (low voltage inverter SchmittTrigger). I have that breadboarded now and problem is gone.
I must have missed the 433Mhz node. tnx

Closed 2020-06-24.

Thread 16 (2017-04-22):

harinazov interrupt disable  w5100.h

consolacion, 2017-04-22:
Sadly the jcw source that harinazov refers to for interupt disabling is dead. just as the link to Arduino.cc. So all i know is that the W5100.h file needs to be amended with:
#else
inline static void initSS() { DDRB |= _BV(2); };
inline static void setSS() { cli(); PORTB &= ~_BV(2); };
inline static void resetSS() { PORTB |= _BV(2); sei(); };
#endif
Am I correct it replaces this section:
 inline static void initSS()    { DDRB  |=  _BV(2); };
 inline static void setSS()     { PORTB &= ~_BV(2); };
 inline static void resetSS()   { PORTB |=  _BV(2); };

computourist, 2017-04-23:
Have a look at: http://homeautomation.proboards.com/post/166
Changes are around line 343 in w5100.h

consolacion, 2017-04-23:
ah, yes, that seems to be the sectionI guessed it was. Tnx

Closed 2017-04-23.

Thread 18 (2018-04-19):

Explanation

flatsiedatsie, 2018-04-19:
The readme is a bit cryptic. Can this be used to
- Switch RF433 wall plugs? Can it learn their codes? Does it store their codes, or pass them along?
- Listen to RF433 signals from sensors, and pass along their data? Like temperature sensors for example?
- Could this be used with Domoticz?
- All one has to do is connect the RFM69 to the Raspberry Pi's pins?

computourist, 2020-06-24:
RTFM

Closed 2020-06-24.

Thread 19 (2020-10-13):

Node can't reach gateway, is a relay node a solution?

Gizzbert, 2020-10-13:
Hi,
I have a node sitting in a faraday cage of sorts, therefore it can't reach the gateway. Is a relay node a solution for that, will it forward all the messages it gets?

cheers

computourist, 2020-10-13:
Hi Gizzbert,
there are several solutions for this. A relay node is certainly possible, but you would have to write the code for it. This should not be too difficult when combining already existing code.

Other possible solutions would be:
- place a second gateway inside the cage. Operating a multitide of gateways within a single network is no problem, if only the MQTT parameters are unique for each gateway.
- place the antenna for the RFM96 outside the cage, using a coaxial feed.
- place the node outside the cage, and connect the sensors and actuators using wired connections.
- use an ESP-based node. It operates using Wifi. This option would only work if Wifi is available within the cage.

Hope this helps....

Computourist
