computourist/RFM69-MQTT-client/(commit log)

2015-01-04 working version
    commit of working sketches and schematics
2015-01-14 DIO0 interrupt connection added
2015-01-22 fixed bug
    Gateway did not re-subscribe to southbound topic after a network outage
    recovery.
    [RFM_MQTT_GW_19.ino]
2015-03-04 Initial commit of Relay end node
2015-03-10 fixed periodic updates, disabled sleep due to unreliable comms, added some more debug statements (need to wrap with ifdef debug still)
    [relay.ino]
2015-03-18 GND connection added
2015-10-25 Gateway 2.3
    retransmission mechanism fixed
    [RFM_DIG_node_22.ino, RFM_MQTT_GW_23.ino]
2015-12-06 added schematic
2016-01-31 version 2.4 is compatible with Arduino IDE
2016-02-05 added schematics
2016-02-05 corrected schematic
2016-02-05 corrected schematics
